javifercep/Curryboard/Doc/CurryboardPCB.pdf

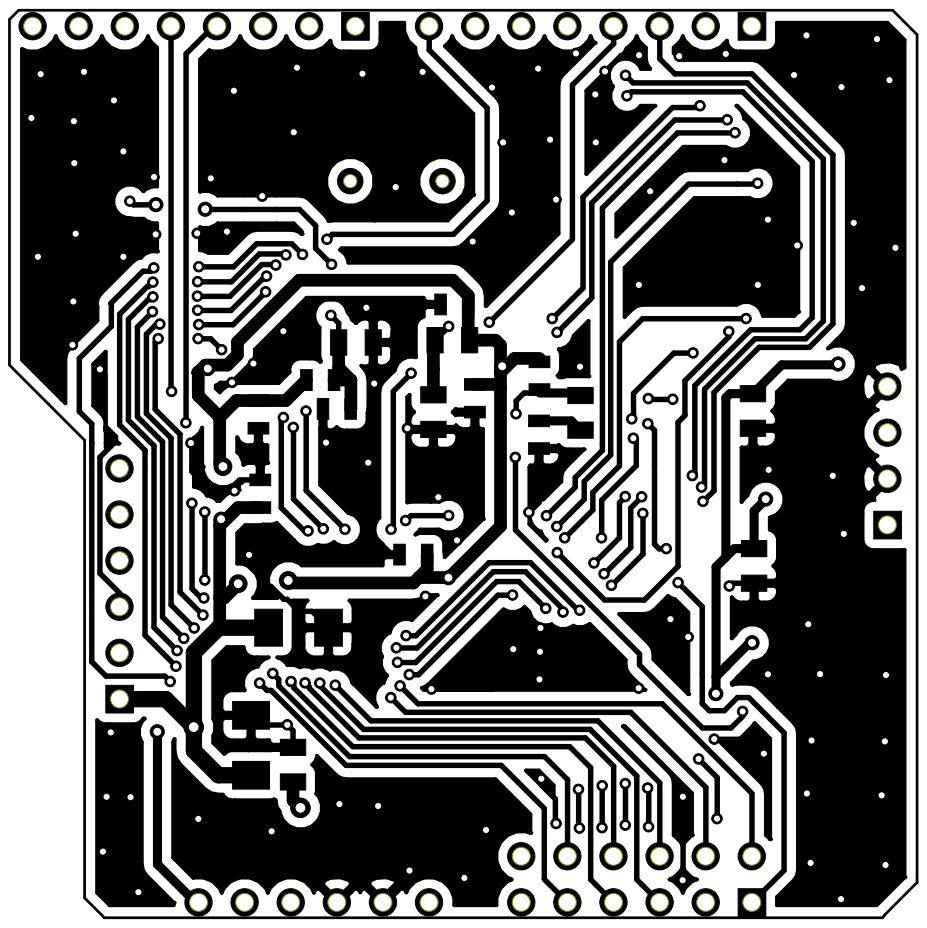
[picture p5: page 1]

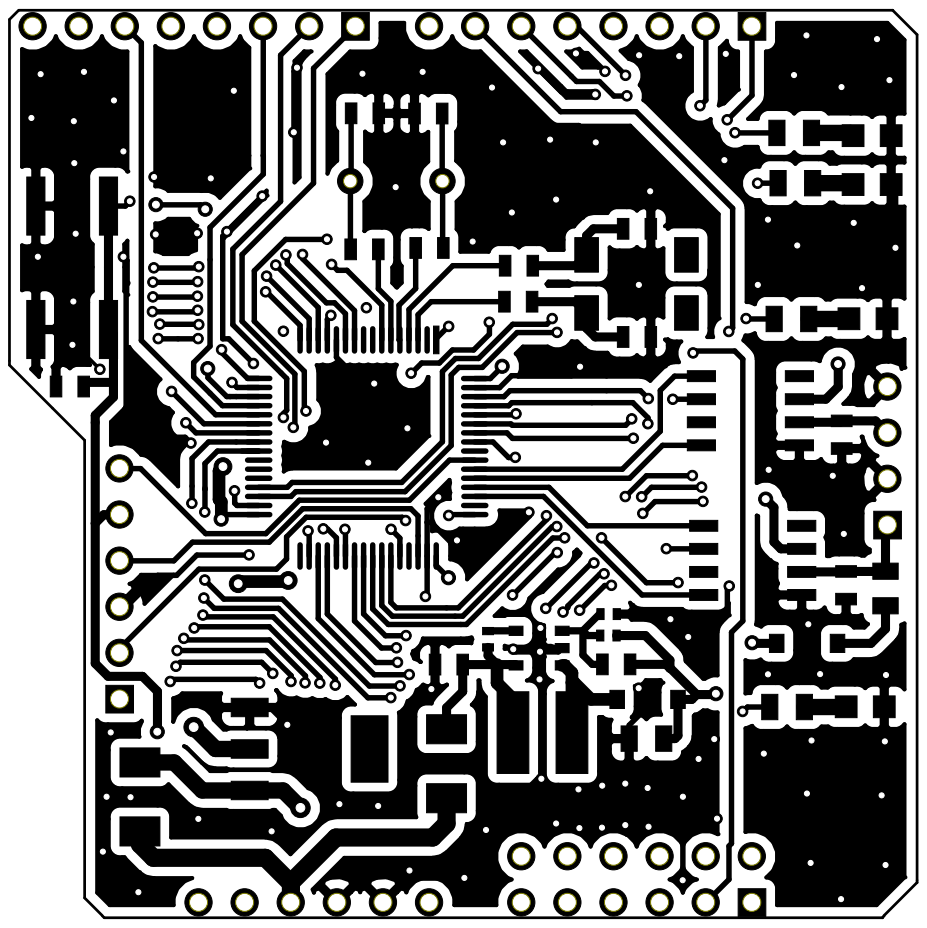
[picture p6: page 2]

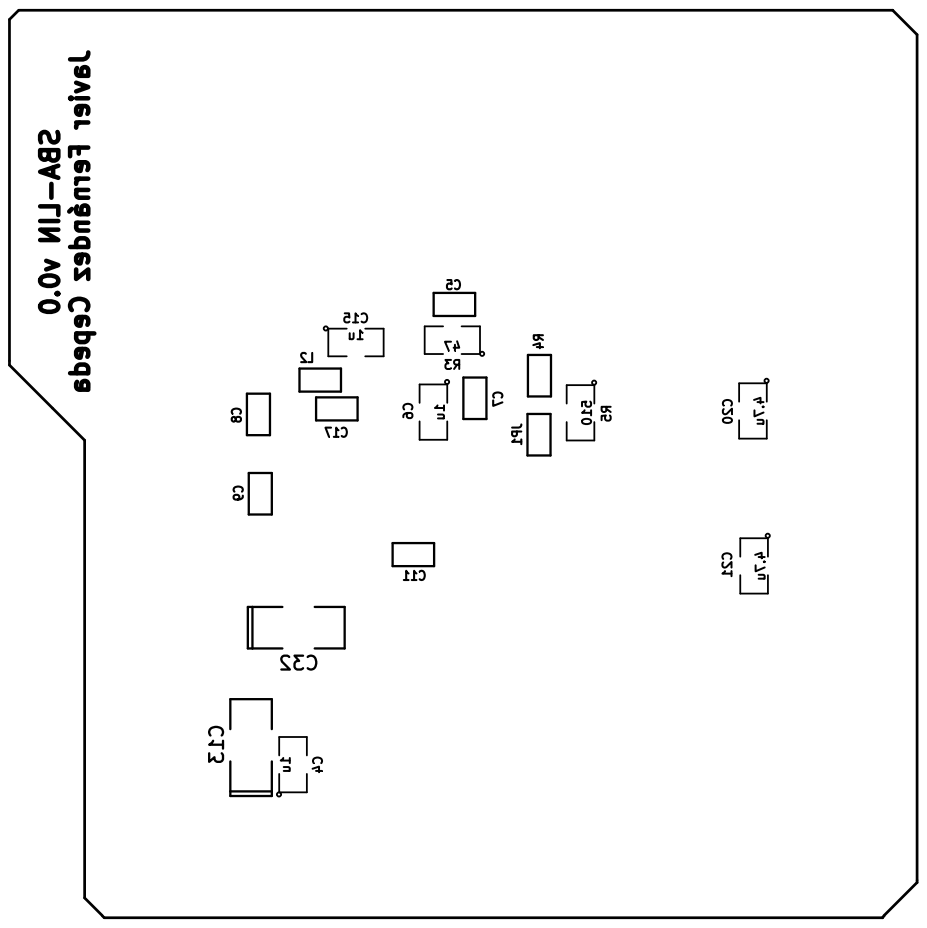
[picture p7: page 3]

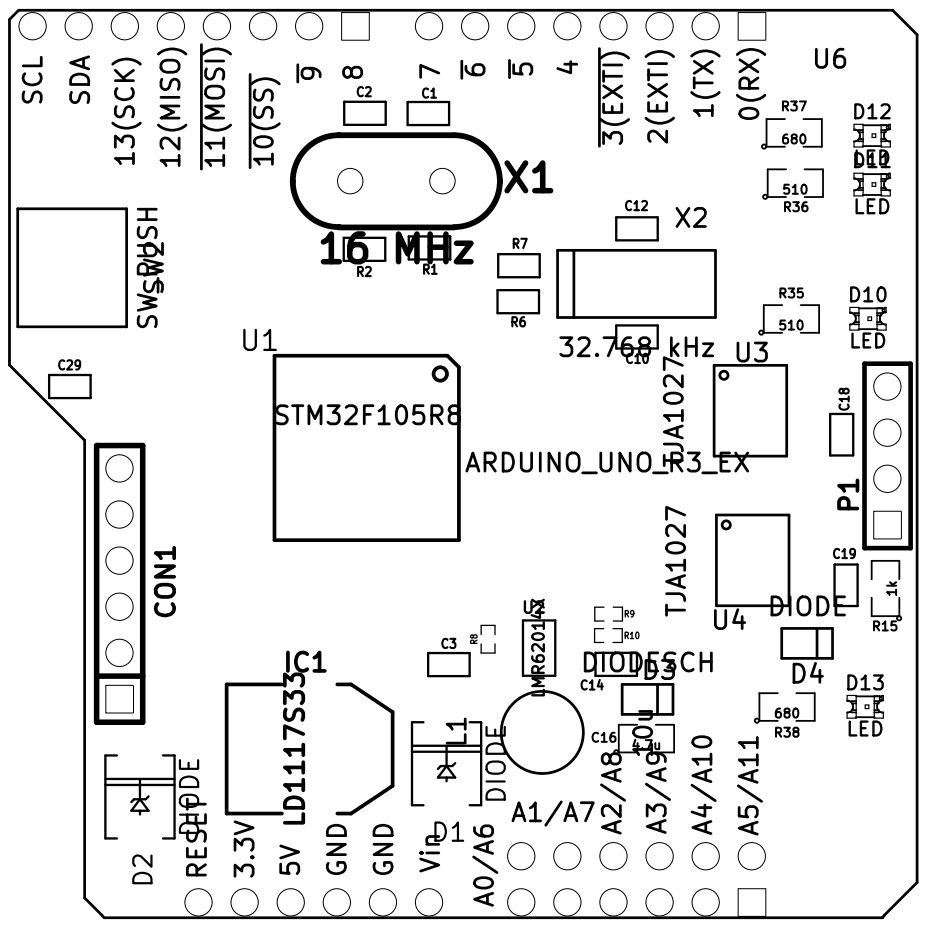
[picture p8: page 4]

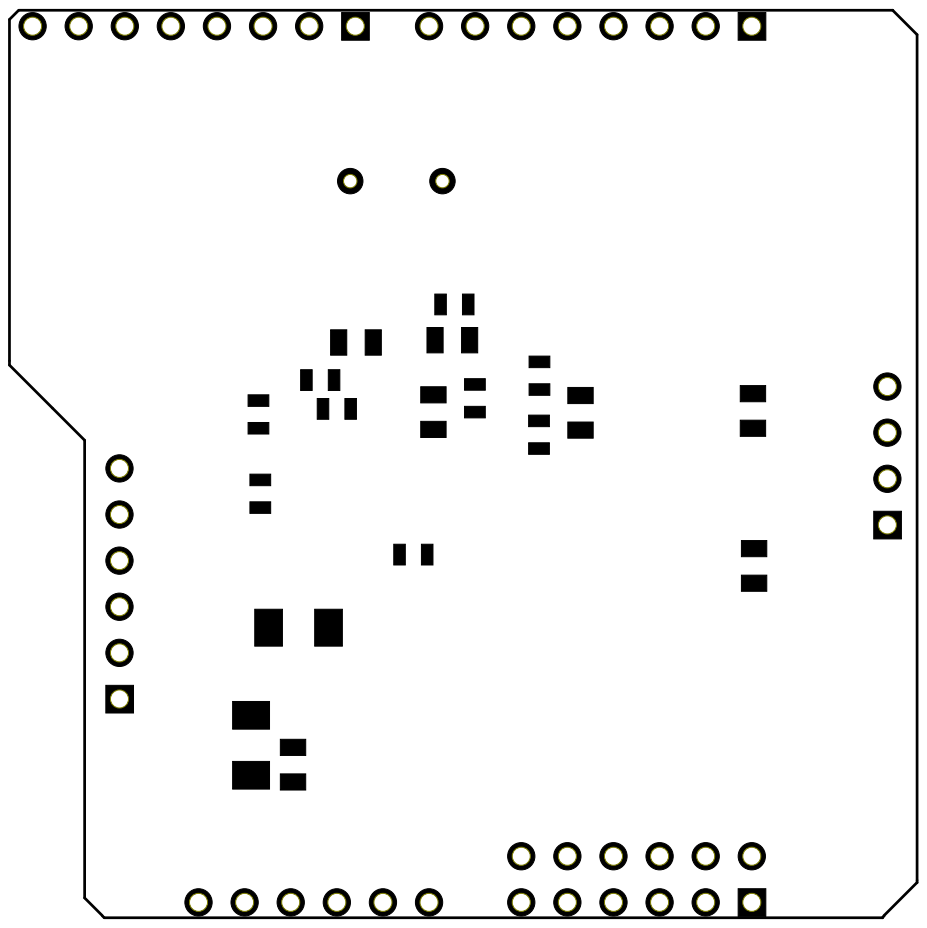
[picture p9: page 5]

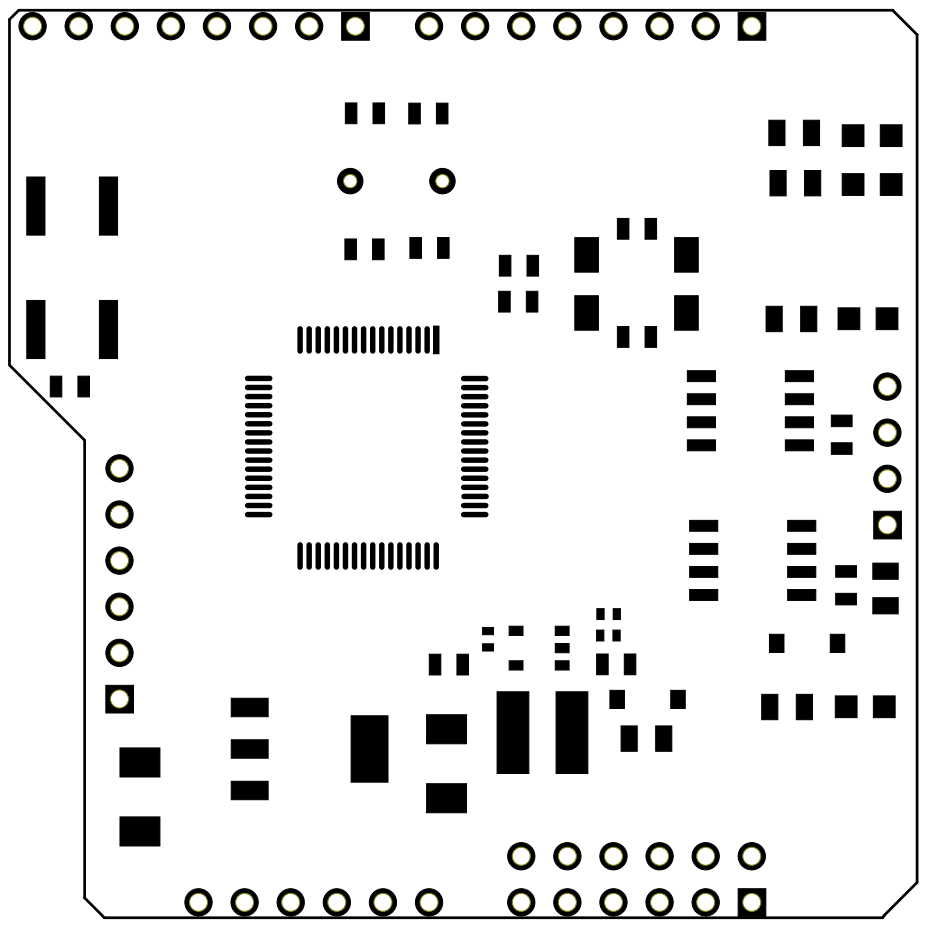
[picture p10: page 6]
