javifercep/Curryboard/Curryboard.kicad_pcb

## KiCad design Curryboard.kicad_pcb (2015-05-23)

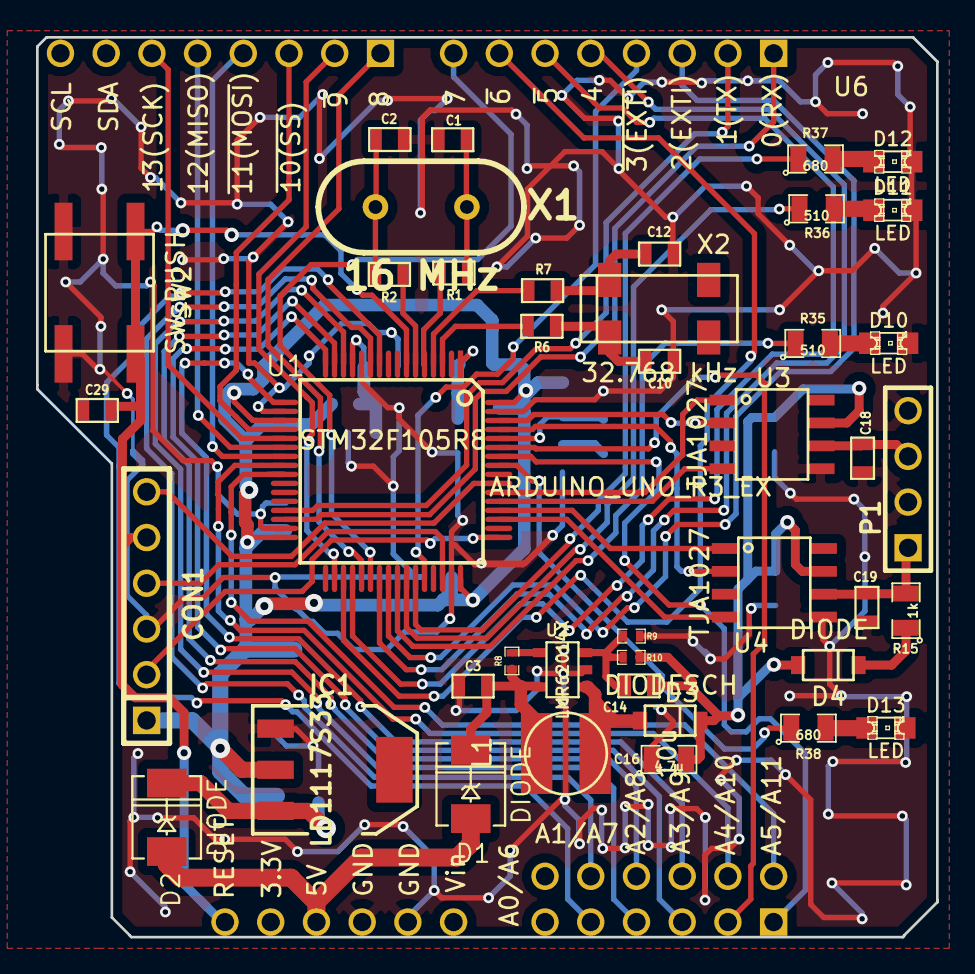
[picture p11: board Curryboard.kicad_pcb from above]

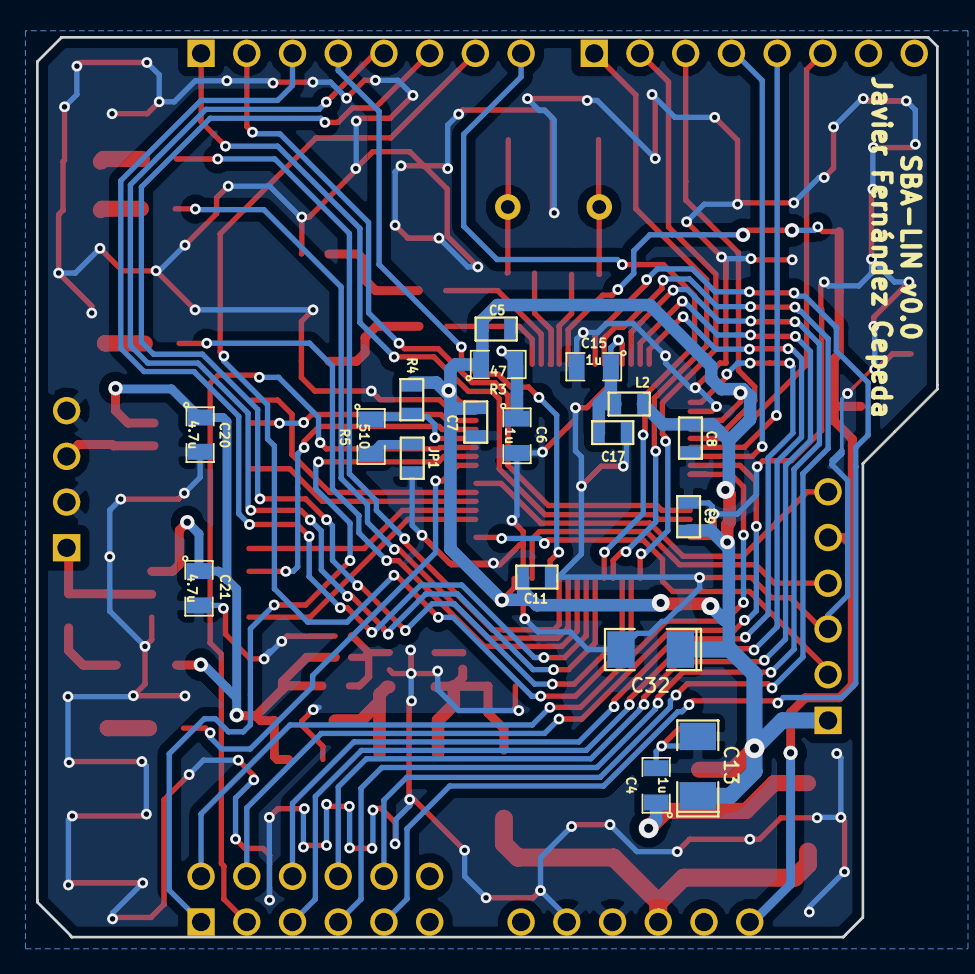
[picture p12: board Curryboard.kicad_pcb from below]

Board: 2 copper layers, 50.0 x 50.0 mm, 60 parts (18 on the bottom side), 66 nets.

Parts:
C1, C2: 4.7p; SM0603
C3: 3.3u; SM0603
C4, C6, C15: 1u; SM0805
C5, C7, C8, C9, C11, C17, C29: 100n; SM0603
C10, C12: 6.8p; SM0603
C13: 10u; SM1206POL
C14: 330p; SM0603
C16, C20, C21: 4.7u; SM0805
C18: 220p; SM0603
C19: 1n; SM0603
C32: 4u7; SM1206POL
CON1: SWD; PIN_ARRAY-6X1
D1, D2: DIODE; DO-214AC(SMA)
D3: DIODESCH; SOD123
D4: DIODE; SOD123
D10, D11, D12, D13: LED; LED-0805
IC1: LD1117S33; SOT223
JP1: JUMPER; SM0603
L1: 10u; 74477310
L2: fcm1608; SM0603
P1: CONN_4; PIN_ARRAY_4x1
R1, R2, R6, R7: 0; SM0603
R3: 47; SM0805
R4: 10k; SM0603
R5, R35, R36: 510; SM0805
R8: 1000k; SM0402
R9: 976; SM0402
R10: 8.66k; SM0402
R15: 1k; SM0805
R37, R38: 680; SM0805
SW2: SW_PUSH; EVQP0
U1: STM32F105R8; LQFP64
U2: LMR62014X; SOT23-5
U3, U4: TJA1027; SOIC8
U6: ARDUINO_UNO_R3_EX; ArduinoUNOShieldR3EX
X1: 16 MHz; HC-49V
X2: 32.768 kHz; RTC

Connections:
/LIN Interface/EN_LIN1: U1.61, U4.2
/LIN Interface/EN_LIN2: U1.62, U3.2
/LIN Interface/LIN1: C19.1, P1.1, R15.2, U4.6
/LIN Interface/LIN2: C18.1, P1.3, U3.6
/LIN Interface/RX_LIN1: U1.52, U4.1
/LIN Interface/RX_LIN2: U1.54, U3.1
/LIN Interface/TX_LIN1: U1.51, U4.4
/LIN Interface/TX_LIN2: U1.53, U3.4
/OSC32_IN: R6.2, U1.3
/OSC32_OUT: R7.2, U1.4
/OSC_IN: R1.2, U1.5
/OSC_OUT: R2.2, U1.6
/Peripherals/5V: D1.1, D2.1, U6.22
/Peripherals/A1: U1.10, U6.18
/Peripherals/A2: U1.14, U6.17
/Peripherals/A3: U1.16, U6.16
/Peripherals/A7: U1.11, U6.29
/Peripherals/A8: U1.15, U6.30
/Peripherals/A9: U1.17, U6.31
/Peripherals/A10: U1.24, U6.32
/Peripherals/A11: U1.25, U6.33
/Peripherals/GPIO1: U1.37, U6.8
/Peripherals/GPIO2: U1.38, U6.7
/Peripherals/GPIO3: U1.39, U6.4
/Peripherals/GPIO4: U1.40, U6.2
/Peripherals/LED1: R35.1, U1.41
/Peripherals/LED2: R36.1, U1.42
/Peripherals/LED3: R37.1, U1.43
/Peripherals/LED4: R38.1, U1.57
/Peripherals/PWM1: U1.34, U6.9
/Peripherals/PWM2: U1.35, U6.6
/Peripherals/PWM3: U1.36, U6.5
/Peripherals/PWM4: U1.44, U6.3
/Peripherals/RESET_BUTTON: C29.1, CON1.5, SW2.1, U1.7, U6.24
/Peripherals/RX: U1.30, U6.0
/Peripherals/SCL: U1.58, U6.14
/Peripherals/SDA: U1.59, U6.15
/Peripherals/SPI_MISO: U1.22, U6.12
/Peripherals/SPI_MOSI: U1.23, U6.11
/Peripherals/SPI_NSS: U1.20, U6.10
/Peripherals/SPI_SCLK: U1.21, U6.13
/Peripherals/TX: U1.29, U6.1
/Power Interface/3V3: C5.1, C7.2, C8.2, C9.2, C11.2, C13.1, C32.1, CON1.1, IC1.2, L2.1, R3.1, R4.1, U1.19, U1.32, U1.48, U1.64
/Power Interface/12V: C14.2, C16.2, C20.1, C21.1, D3.2, D4.1, R10.2, U3.7, U4.7
/Power Interface/VDDA: C15.1, C17.1, L2.2, U1.13
/SWCLK: CON1.2, U1.49
/SWDIO: CON1.4, U1.46
/SWO: CON1.6, U1.55
GND: C1.1, C2.1, C3.2, C4.2, C5.2, C6.2, C7.1, C8.1, C9.1, C10.1, C11.1, C12.1, C13.2, C15.2, C16.1, C17.2, C18.2, C19.2, C20.2, C21.2, C29.2, C32.2, CON1.3, D10.2, D11.2, D12.2, D13.2, IC1.1, JP1.2, P1.2, P1.4, R9.2, SW2.2, U1.12, U1.18, U1.31, U1.47, U1.63, U2.2, U3.5, U4.5, U6.21, U6.25
unnamed: JP1.1, R5.2
unnamed: C6.1, R3.2, U1.1
unnamed: R4.2, R5.1, U1.60
unnamed: C1.2, R1.1, X1.2
unnamed: C2.2, R2.1, X1.1
unnamed: C10.2, R6.1, X2.2
unnamed: C12.2, R7.1, X2.1
unnamed: D11.1, R36.2
unnamed: D10.1, R35.2
unnamed: D13.1, R38.2
unnamed: D12.1, R37.2
unnamed: D4.2, R15.1
unnamed: C3.1, D1.2, L1.1, R8.1, U2.5
unnamed: R8.2, U2.4
unnamed: C14.1, R9.1, R10.1, U2.3
unnamed: C4.1, D2.2, IC1.3
unnamed: D3.1, L1.2, U2.1
